lonlionl/STM32-smart-medicine-box-system/(commit log)

2026-10-10 初始提交：STM32 智能药箱系统（固件 + Web 端 + 文档）
2026-10-10 tools: 用 README.md 取代 FILE_ENCODING.md
2026-10-10 docs: 开发历程只保留开发问题，重排编号与交叉引用
2026-10-10 docs: 开发历程消除折行、重排编号、加书签与目录
2026-10-10 docs: 目录标题改用 TOC Heading，README 条目数校正
